swallow-project/swallow-ethernet-sdram-board/Manufacturing/BOM/Swallow-ethernet-BOM.xls

Swallow_Ethernet design V1
Bill of Materials
2012-10-10
Key:
Populated
Unpopulated
PCB Train free issue
ref | value | footprint
C1 | 10n | SM0402 | 040210nF 50V 10% X7R
C2 | 47n | SM0603 | 060347nF 16V 10% X7R
C3 | 100n | SM0603 | 0603100nF 25V 10% X7R
C4 | 100n | SM0603 | 0603100nF 25V 10% X7R
C5 | 10uF | SM0805 | 080510uF 6.3V 10% X5R
C6 | 100n | SM0603 | 0603100nF 25V 10% X7R
C7 | 100n | SM0603 | 0603101nF 25V 10% X7R
C8 | 100n | SM0603 | 0603102nF 25V 10% X7R
C9 | 100n | SM0603 | 0603103nF 25V 10% X7R
C10 | 100n | SM0603 | 0603104nF 25V 10% X7R
C11 | 10u | SM0805 | 080510uF 6.3V 10% X5R
C12 | 100n | SM0603 | 0603100nF 25V 10% X7R
C13 | 100n | SM0603 | 0603101nF 25V 10% X7R
C14 | 100n | SM0603 | 0603102nF 25V 10% X7R
C15 | 100n | SM0603 | 0603103nF 25V 10% X7R
C16 | 10u | SM0805 | 080510uF 6.3V 10% X5R
C17 | 10u | SM1206 | 120610uF 25V Z% Y5V
C18 | 10u | SM1206 | 120610uF 25V Z% Y5V
C19 | 33p | SM0603 | 060333pF 50V 5% C0G
C20 | 33p | SM0603 | 060333pF 50V 5% C0G
C21 | 10u | SM0805 | 080510uF 6.3V 10% X5R
C22 | 10u | SM0805 | 080510uF 6.3V 10% X5R |  |  |  | Price (assuming 10 boards)
C23 | 100n | SM0603 | 0603100nF 25V 10% X7R
D1 | MEM_LED | X_LED-0603 | Kingbright | KPT-1608EC | 2099221 | http://uk.farnell.com/kingbright/kpt-1608ec/led-red-0603-smd/dp/2099221?in_merch=New%20Products | 0.05
D2 | L1_LED | X_LED-0603 | Kingbright | KPT-1608EC | 2099221 | http://uk.farnell.com/kingbright/kpt-1608ec/led-red-0603-smd/dp/2099221?in_merch=New%20Products | 0.05
D3 | POWER_OK | X_LED-0603 | Dialight | 5988070107F | 1465991RL | http://uk.farnell.com/dialight/5988070107f/led-0603-green/dp/1465991RL | 0.26
D4 | RESET | X_LED-0603 | Dialight | 5988070107F | 1465991RL | http://uk.farnell.com/dialight/5988070107f/led-0603-green/dp/1465991RL | 0.26
L1 | 2.2uH | SM0805 | Taiyo Yuden | CBC2012T2R2M | 9544348 | http://uk.farnell.com/taiyo-yuden/cbc2012t2r2m/power-inductor-2-2uh-530ma-20/dp/9544348 | 0.1 | US
L2 | 2.2uH | SM0805 | Taiyo Yuden | CBC2012T2R2M | 9544348 | http://uk.farnell.com/taiyo-yuden/cbc2012t2r2m/power-inductor-2-2uh-530ma-20/dp/9544348 | 0.1 | US
P1 | XTAG2 | pin_array_10x2 | Harwin | M20-9990245 | 1022245 | http://uk.farnell.com/harwin/m20-9990245/header-1row-2way/dp/1022245 | 0.098
P2 | XMP16_TR_Link | FFC5-xx-R-L-Tx | Toby | FFC5-30-R-L-TU |  | http://www.toby.co.uk/content/catalogue/products.aspx?series=FFC5-xx-R-L-Tx | 0.62
P3 | TR_Link_Out | FFC5-xx-R-L-Tx | Toby | FFC5-30-R-L-TU |  | http://www.toby.co.uk/content/catalogue/products.aspx?series=FFC5-xx-R-L-Tx | 0.62
P4 | Mode_Select | SIL-2 | Harwin | M20-9990245 | 1022245 | http://uk.farnell.com/harwin/m20-9990245/header-1row-2way/dp/1022245 | 0.098
P5 | Ethernet_Slice | PCIe 36 way throughole vertical | Samtec | PCIE-036-02-F-D-TH | 1753906 | http://uk.farnell.com/samtec/pcie-036-02-f-d-th/socket-pci-e-2x18/dp/1753906 | 1.27
P6 | V_In
P7 | +5V_In | DC-8S | Cliff | FC68145S | 224947 | http://uk.farnell.com/cliff-electronic-components/dc8/socket-pcb-dc-power-1-3mm-pk10/dp/224947 | 0.573 | (pack of 10)
P8 | PCIe_extra
P9 | RESET_N
P10 | CONN_14
P11 | CONN_8
P12 | CONN_3
P13 | CONN_2
P14 | CONN_2
P15 | CONN_2
P16 | CONN_2
P17 | CONN_2
R1 | 33R | SM0402 | 040233R 1%
R2 | 33R | SM0402 | 040233R 1%
R5 | 4R7 | SM0402 | 04024R7 1%
R6 | 100k | SM0402 | 0402100K 1%
R7 | 100k | SM0402 | 0402100K 1%
R8 | 453k | SM0603 | Vishay | CRCW0603453KFKEA | 2138564 | http://uk.farnell.com/vishay-draloric/crcw0603453kfkea/resistor-0603-453k-1/dp/2138564?in_merch=New%20Products | 0.025 | (min 50 order factored in)
R9 | 68k | SM0402 | 040268K 1%
U1 | 25MHz_ASE_CLK | TC Series | TCX | TC-25.000MBD-T | 2100537 | http://uk.farnell.com/txc/tc-25-000mbd-t/oscillator-mems-cmos-25mhz-smd/dp/2100537 | 1.15 | US
U2 | 4k7 | YC124-JR | Yageo | YC124-JR-074K7L | 9235400RL | http://uk.farnell.com/yageo-phycomp/yc124-jr-074k7l/resistor-array-arv341-0804-4k7/dp/9235400RL | 0.112
U3 | 33R | YC124-JR | Yageo | YC124-JR-0733RL | 9235272RL | http://uk.farnell.com/yageo-phycomp/yc124-jr-0733rl/resistor-array-arv341-0804-33r/dp/9235272RL | 0.116
U4 | 33R | YC124-JR | Yageo | YC124-JR-0733RL | 9235272RL | http://uk.farnell.com/yageo-phycomp/yc124-jr-0733rl/resistor-array-arv341-0804-33r/dp/9235272RL | 0.116
U5 | NC7WZ07 | SC70-6 | Fairchild | NC7WZ07P6X | 1470998 | http://uk.farnell.com/fairchild-semiconductor/nc7wz07p6x/ic-nc7wz-smd/dp/1470998 | 0.24
U6 | NC7WZ07 | SC70-6 | Fairchild | NC7WZ07P6X | 1470998 | http://uk.farnell.com/fairchild-semiconductor/nc7wz07p6x/ic-nc7wz-smd/dp/1470998 | 0.24
U7 | 4k7 | YC124-JR | Yageo | YC124-JR-074K7L | 9235400RL | http://uk.farnell.com/yageo-phycomp/yc124-jr-074k7l/resistor-array-arv341-0804-4k7/dp/9235400RL | 0.112
U8 | MX25L6445EM2I-10G | SO8NL | Macronix | MX25L6445EM2I-10G | 1092-1065-ND | http://www.digikey.com/product-search/en?x=0&y=0&lang=en&site=us&KeyWords=MX25L6445EM2I-10G+ | 1.92
U9 | DRAM-2MX16X4 | TSSOP-54 | Hynix | H57V2562GTR-75C | 1907383 | http://uk.farnell.com/hynix-semiconductor/h57v2562gtr-75c/sdram-256mb-x16-54tsopii/dp/1907383 | 2.26
U10 | XS1-L1-128 | XMOS_X1-L1_128TQFP | XMOS | XS1-L01A-TQ128-C5 | 880-1019-ND | http://www.digikey.com/product-detail/en/XS1-L01A-TQ128-C5/880-1019-ND/2333460 | 10
U11 | NCP1529 | TSOP-5 | ON Semi | NCP1529ASNT1G | 1642398 | http://uk.farnell.com/on-semiconductor/ncp1529asnt1g/ic-step-down-dc-dc-converter-tsop/dp/1642398 | 0.518
U12 | NCP1529 | TSOP-5 | ON Semi | NCP1529ASNT1G | 1642398 | http://uk.farnell.com/on-semiconductor/ncp1529asnt1g/ic-step-down-dc-dc-converter-tsop/dp/1642398 | 0.518
U13 | NCP303LSN09T1G | TSOP-5 | ON Semi | NCP303LSN09T1G | 1364634 | http://uk.farnell.com/on-semiconductor/ncp303lsn09t1g/ic-volt-detector-0-45%C2%B5a-10v-tsop/dp/1364634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 | 0.236
U14 | 82R |  | Yageo | YC124-JR-074K7L | 9235400 | http://uk.farnell.com/yageo-phycomp/yc124-jr-074k7l/resistor-array-arv341-0804-4k7/dp/9235400 | 0.112
U15 | TS3A5018 |  | TI | TS3A5018PWG4 | 1494943 | http://uk.farnell.com/texas-instruments/ts3a5018pwg4/switch-analog-spdt-quad-10r-smd/dp/1494943 | 0.72
U16 | NC7WZ17 | SC70-6 | Fairchild | NC7WZ17P6X | 1651986RL | http://uk.farnell.com/fairchild-semiconductor/nc7wz17p6x/ic-buffers-drivers-receivers/dp/1651986RL | 0.2
W1 | CLK_EN | TestPad-1mm
W2 | CLK | TestPad-1mm
W3 | GPIO1 | TestPad-1mm
W4 | GPIO2 | TestPad-1mm
W5 | MODE3 | TestPad-1mm
W7 | 3V3Reg | TestPad-1mm
W8 | 1VReg | TestPad-1mm
W9 | 1VFB | TestPad-1mm
W10 | 3V3FB | TestPad-1mm
W11 | 3V3 | TestPad-1mm
W12 | 1V | TestPad-1mm
W13 | RESET_N | TestPad-1mm
 | 30 unique lines
 | 58 total parts
