swallow-project/swallow-ethernet-sdram-board/Swallow-ethernet.sch

## KiCad design Swallow-ethernet.sch (2012-12-03, an earlier design)

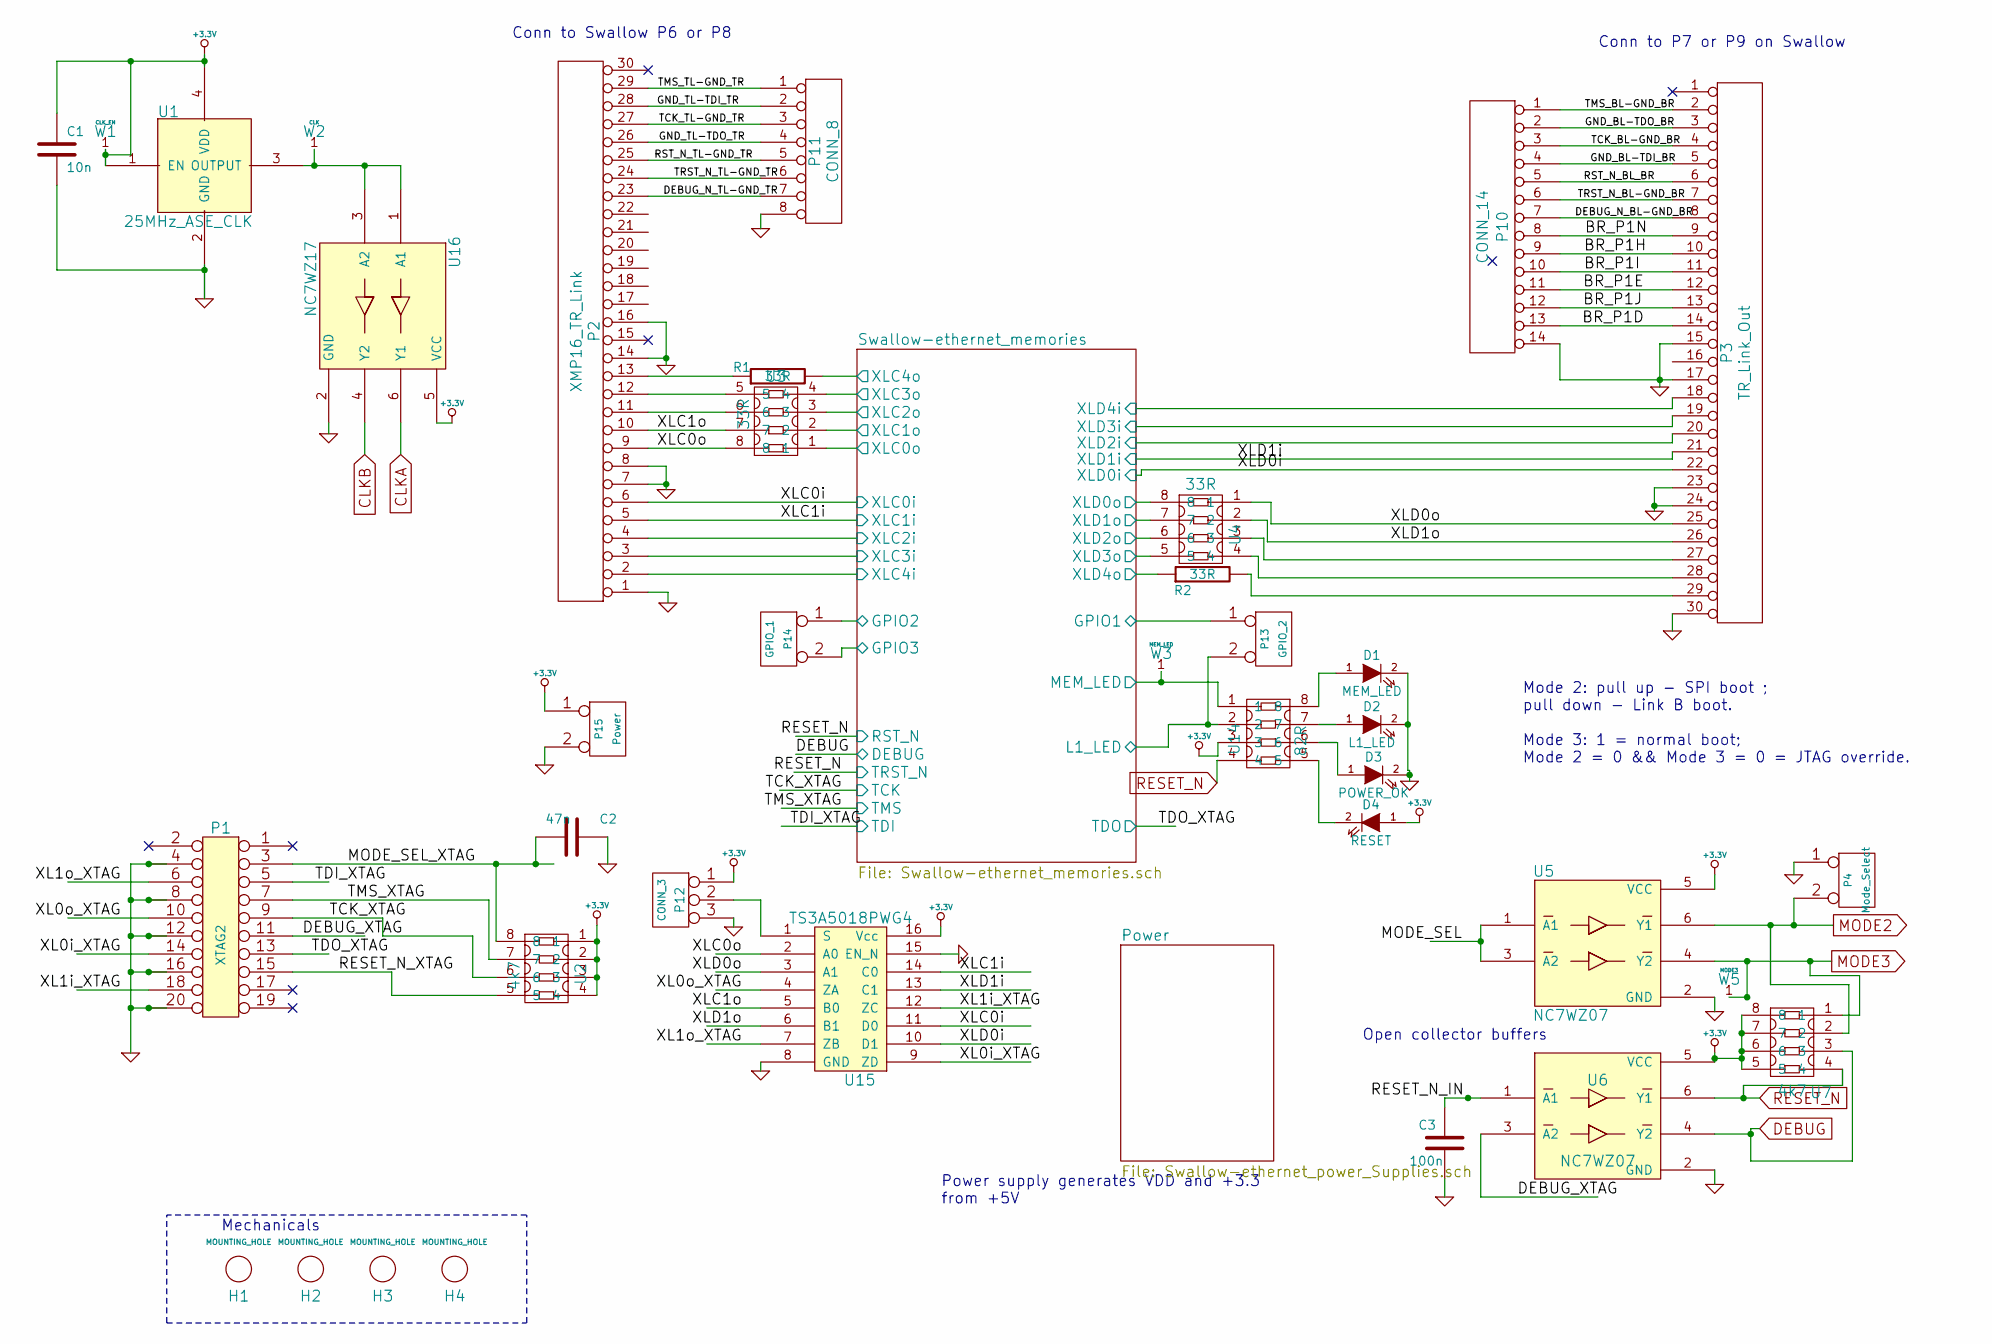
[picture p6: schematic Swallow-ethernet.sch]

Parts:
C1: 10n; SM0402
C2: 47n; SM0603
C3: 100n; SM0603
D1: MEM_LED; X_LED-0603
D2: L1_LED; X_LED-0603
D3: POWER_OK; X_LED-0603
D4: RESET; X_LED-0603
H1, H2, H3, H4: MOUNTING_HOLE
P1: XTAG2; pin_array_10x2
P2: XMP16_TR_Link; FFC5-xx-R-L-Tx
P3: TR_Link_Out; FFC5-xx-R-L-Tx
P4: Mode_Select; SIL-2
P10: CONN_14
P11: CONN_8
P12: CONN_3
P13: GPIO_2
P14: GPIO_1
P15: Power
R1, R2: 33R; SM0402
U1: 25MHz_ASE_CLK; ASEseries
U2, U7: 4k7; YC124-JR
U3, U4: 33R; YC124-JR
U5, U6: NC7WZ07; SC70-6
U14: 82R
U15: TS3A5018PWG4
U16: NC7WZ17
W1: CLK_EN; TestPad-1mm
W2: CLK; TestPad-1mm
W3: MEM_LED; TestPad-1mm
W5: MODE3; TestPad-1mm

Connections:
+3.3V: C1.1, D4.1 (A), P12.1, P15.1, U1.1 (EN), U1.4 (VDD), U2.1, U2.2, U2.3, U2.4, U5.5 (VCC), U6.5 (VCC), U7.5, U7.6, U7.7, U7.8, U14.3, U15.16 (Vcc), U16.5 (VCC), W1.1
BR_P1D: P3.14, P10.13
BR_P1E: P3.12, P10.11
BR_P1H: P3.10, P10.9
BR_P1I: P3.11, P10.10
BR_P1J: P3.13, P10.12
BR_P1N: P3.9, P10.8
CLKA: U16.6 (Y1)
CLKB: U16.4 (Y2)
DEBUG: U6.4 (Y2), U7.3
DEBUG_N_BL-GND_BR: P3.8, P10.7
DEBUG_N_TL-GND_TR: P2.23, P11.7
DEBUG_XTAG: P1.11, U6.3 (A2)
GND: C1.2, C2.1, C3.2, D1.2 (K), D2.2 (K), D3.2 (K), P1.4, P1.8, P1.12, P1.16, P1.20, P2.1, P2.7, P2.8, P2.14, P2.16, P3.15, P3.17, P3.23, P3.24, P3.30, P4.1, P10.14, P11.8, P12.3, P15.2 (PM), U1.2 (GND), U5.2 (GND), U6.2 (GND), U15.8 (GND), U15.15 (EN_N), U16.2 (GND)
GND_BL-TDI_BR: P3.5, P10.4
GND_BL-TDO_BR: P3.3, P10.2
GND_TL-TDI_TR: P2.28, P11.2
GND_TL-TDO_TR: P2.26, P11.4
GPIO1: P13.1
GPIO2: P14.1
GPIO3: P14.2 (PM)
L1_LED: P13.2 (PM), U14.2
MEM_LED: U14.1, W3.1
MODE2: P4.2 (PM), U5.6 (Y1), U7.2
MODE3: U5.4 (Y2), U7.1, W5.1
MODE_SEL: U5.1 (A1), U5.3 (A2)
MODE_SEL_XTAG: C2.2, P1.3, U2.8
unnamed: D1.1 (A), U14.8
unnamed: D2.1 (A), U14.7
unnamed: D3.1 (A), U14.6
unnamed: D4.2 (K), U14.5
unnamed: P2.11, U3.6
unnamed: P2.12, U3.5
unnamed: P2.13, R1.1
unnamed: P3.27, U4.3
unnamed: P3.28, U4.4
unnamed: P3.29, R2.2
unnamed: P12.2 (PM), U15.1 (S)
unnamed: U1.3 (OUTPUT), U16.1 (A1), U16.3 (A2), W2.1
RESET_N: U6.6 (Y1), U7.4, U14.4
RESET_N_IN: C3.1, U6.1 (A1)
RESET_N_XTAG: P1.15, U2.5
RST_N_BL_BR: P3.6, P10.5
RST_N_TL-GND_TR: P2.25, P11.5
TCK_BL-GND_BR: P3.4, P10.3
TCK_TL-GND_TR: P2.27, P11.3
TCK_XTAG: P1.9, U2.6
TDI_XTAG: P1.5
TDO_XTAG: P1.13
TMS_BL-GND_BR: P3.2, P10.1
TMS_TL-GND_TR: P2.29, P11.1
TMS_XTAG: P1.7, U2.7
TRST_N_BL-GND_BR: P3.7, P10.6
TRST_N_TL-GND_TR: P2.24, P11.6
XL0i_XTAG: P1.14, U15.9 (ZD)
XL0o_XTAG: P1.10, U15.4 (ZA)
XL1i_XTAG: P1.18, U15.12 (ZC)
XL1o_XTAG: P1.6, U15.7 (ZB)
XLC0i: P2.6, U15.11 (D0)
XLC0o: P2.9, U3.1, U3.8, U15.2 (A0)
XLC1i: P2.5, U15.14 (C0)
XLC1o: P2.10, U3.2, U3.7, U15.5 (B0)
XLC2i: P2.4
XLC2o: U3.3
XLC3i: P2.3
XLC3o: U3.4
XLC4i: P2.2
XLC4o: R1.2
XLD0i: P3.22, U15.10 (D1)
XLD0o: P3.25, U4.1, U4.8, U15.3 (A1)
XLD1i: P3.21, U15.13 (C1)
XLD1o: P3.26, U4.2, U4.7, U15.6 (B1)
XLD2i: P3.20
XLD2o: U4.6
XLD3i: P3.19
XLD3o: U4.5
XLD4i: P3.18
XLD4o: R2.1

Notes on the sheet:
Mechanicals
Conn to Swallow P6 or P8
Conn to P7 or P9 on Swallow
Mode 2: pull up - SPI boot ; pull down - Link B boot. Mode 3: 1 = normal boot; Mode 2 = 0 && Mode 3 = 0 = JTAG override.
Open collector buffers
Power supply generates VDD and +3.3 from +5V
