swallow-project/swallow-ethernet-sdram-board/Swallow-ethernet_XS1-L1-128-ports.sch

## KiCad design Swallow-ethernet_XS1-L1-128-ports.sch (2012-12-03, an earlier design)

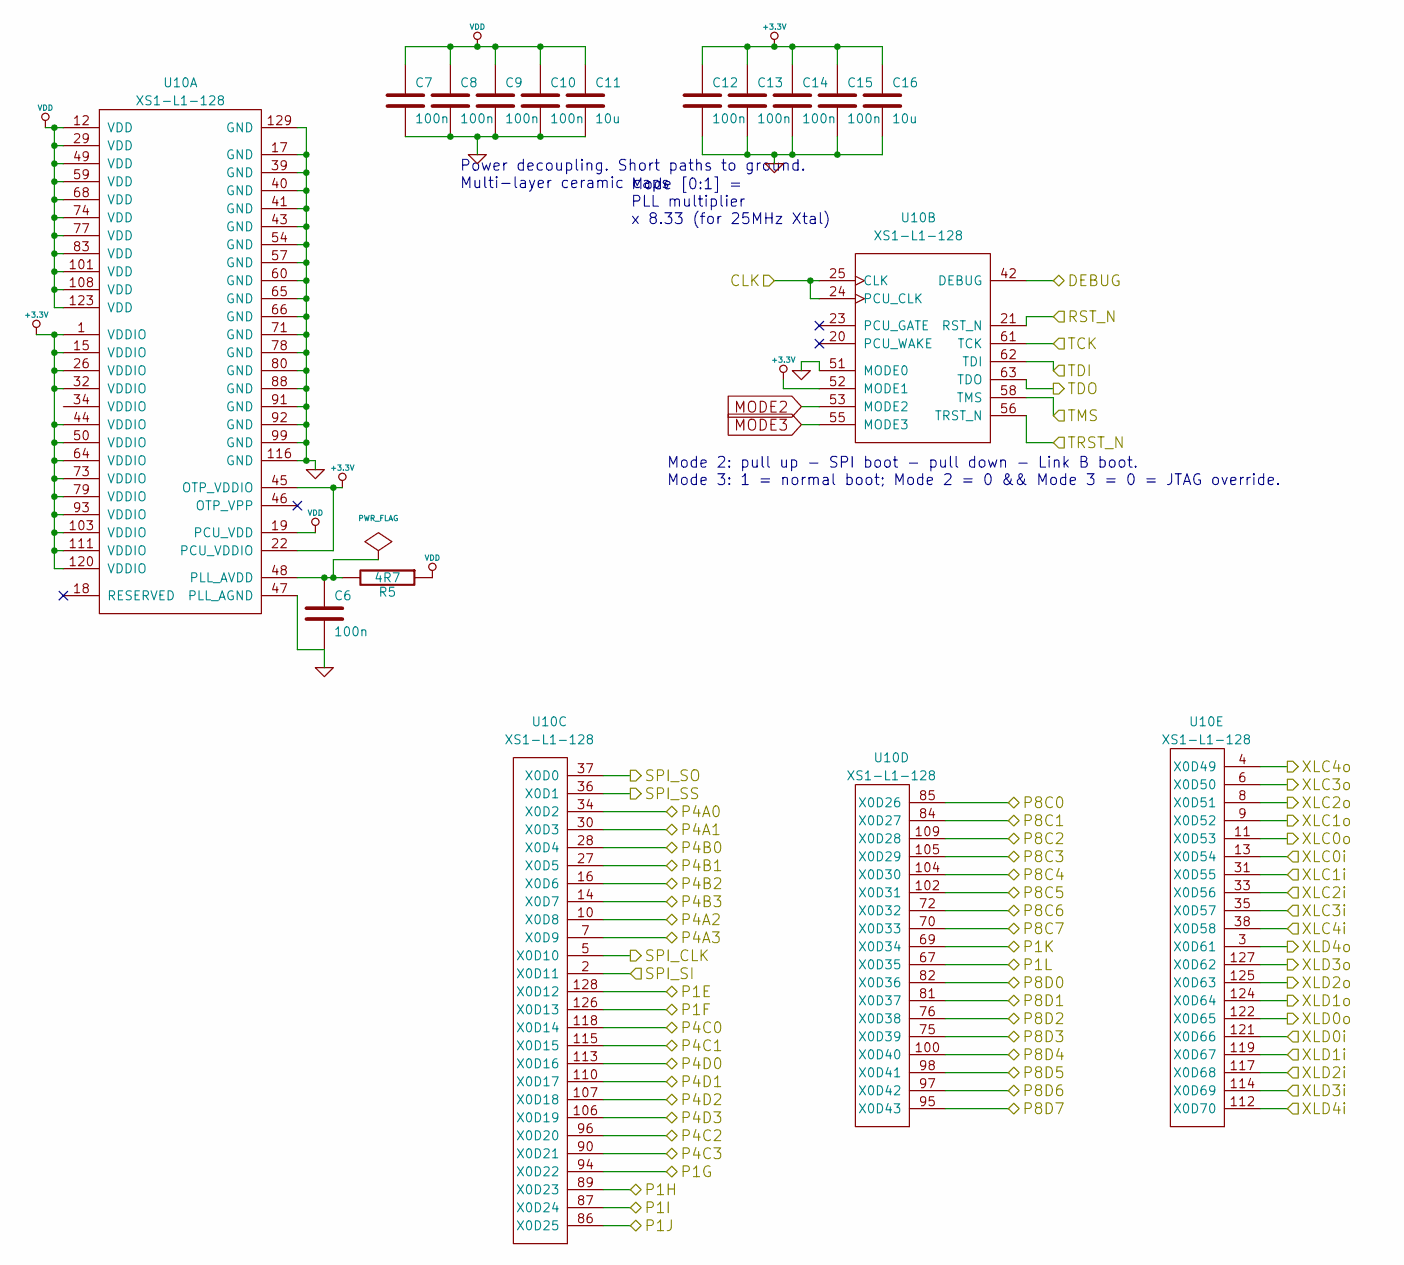
[picture p7: schematic Swallow-ethernet_XS1-L1-128-ports.sch]

Parts:
C6, C7, C8, C9, C10, C12, C13, C14, C15: 100n; SM0603
C11, C16: 10u; SM0805
R5: 4R7; SM0402
U10: XS1-L1-128; XMOS_X1-L1_128TQFP

Connections:
+3.3V: C12.1, C13.1, C14.1, C15.1, C16.1, U10.1 (VDDIO), U10.15 (VDDIO), U10.22 (PCU_VDDIO), U10.26 (VDDIO), U10.32 (VDDIO), U10.44 (VDDIO), U10.45 (OTP_VDDIO), U10.50 (VDDIO), U10.52 (MODE1), U10.64 (VDDIO), U10.73 (VDDIO), U10.79 (VDDIO), U10.93 (VDDIO), U10.103 (VDDIO), U10.111 (VDDIO), U10.120 (VDDIO)
CLK: U10.24 (PCU_CLK), U10.25 (CLK)
DEBUG: U10.42 (DEBUG)
GND: C6.2, C7.2, C8.2, C9.2, C10.2, C11.2, C12.2, C13.2, C14.2, C15.2, C16.2, U10.17 (GND), U10.39 (GND), U10.40 (GND), U10.41 (GND), U10.43 (GND), U10.47 (PLL_AGND), U10.51 (MODE0), U10.54 (GND), U10.57 (GND), U10.60 (GND), U10.65 (GND), U10.66 (GND), U10.71 (GND), U10.78 (GND), U10.80 (GND), U10.88 (GND), U10.91 (GND), U10.92 (GND), U10.99 (GND), U10.116 (GND), U10.129 (GND)
MODE2: U10.53 (MODE2)
MODE3: U10.55 (MODE3)
unnamed: C6.1, R5.2, U10.48 (PLL_AVDD)
P1E: U10.128 (X0D12)
P1F: U10.126 (X0D13)
P1G: U10.94 (X0D22)
P1H: U10.89 (X0D23)
P1I: U10.87 (X0D24)
P1J: U10.86 (X0D25)
P1K: U10.69 (X0D34)
P1L: U10.67 (X0D35)
P4A0: U10.34 (VDDIO)
P4A1: U10.30 (X0D3)
P4A2: U10.10 (X0D8)
P4A3: U10.7 (X0D9)
P4B0: U10.28 (X0D4)
P4B1: U10.27 (X0D5)
P4B2: U10.16 (X0D6)
P4B3: U10.14 (X0D7)
P4C0: U10.118 (X0D14)
P4C1: U10.115 (X0D15)
P4C2: U10.96 (X0D20)
P4C3: U10.90 (X0D21)
P4D0: U10.113 (X0D16)
P4D1: U10.110 (X0D17)
P4D2: U10.107 (X0D18)
P4D3: U10.106 (X0D19)
P8C0: U10.85 (X0D26)
P8C1: U10.84 (X0D27)
P8C2: U10.109 (X0D28)
P8C3: U10.105 (X0D29)
P8C4: U10.104 (X0D30)
P8C5: U10.102 (X0D31)
P8C6: U10.72 (X0D32)
P8C7: U10.70 (X0D33)
P8D0: U10.82 (X0D36)
P8D1: U10.81 (X0D37)
P8D2: U10.76 (X0D38)
P8D3: U10.75 (X0D39)
P8D4: U10.100 (X0D40)
P8D5: U10.98 (X0D41)
P8D6: U10.97 (X0D42)
P8D7: U10.95 (X0D43)
RST_N: U10.21 (RST_N)
SPI_CLK: U10.5 (X0D10)
SPI_SI: U10.2 (X0D11)
SPI_SO: U10.37 (X0D0)
SPI_SS: U10.36 (X0D1)
TCK: U10.61 (TCK)
TDI: U10.62 (TDI)
TDO: U10.63 (TDO)
TMS: U10.58 (TMS)
TRST_N: U10.56 (TRST_N)
VDD: C7.1, C8.1, C9.1, C10.1, C11.1, R5.1, U10.12 (VDD), U10.19 (PCU_VDD), U10.29 (VDD), U10.49 (VDD), U10.59 (VDD), U10.68 (VDD), U10.74 (VDD), U10.77 (VDD), U10.83 (VDD), U10.101 (VDD), U10.108 (VDD), U10.123 (VDD)
XLC0i: U10.13 (X0D54)
XLC0o: U10.11 (X0D53)
XLC1i: U10.31 (X0D55)
XLC1o: U10.9 (X0D52)
XLC2i: U10.33 (X0D56)
XLC2o: U10.8 (X0D51)
XLC3i: U10.35 (X0D57)
XLC3o: U10.6 (X0D50)
XLC4i: U10.38 (X0D58)
XLC4o: U10.4 (X0D49)
XLD0i: U10.121 (X0D66)
XLD0o: U10.122 (X0D65)
XLD1i: U10.119 (X0D67)
XLD1o: U10.124 (X0D64)
XLD2i: U10.117 (X0D68)
XLD2o: U10.125 (X0D63)
XLD3i: U10.114 (X0D69)
XLD3o: U10.127 (X0D62)
XLD4i: U10.112 (X0D70)
XLD4o: U10.3 (X0D61)

Notes on the sheet:
Mode 2: pull up - SPI boot - pull down - Link B boot. Mode 3: 1 = normal boot; Mode 2 = 0 && Mode 3 = 0 = JTAG override.
Mode [0:1] = PLL multiplier x 8.33 (for 25MHz Xtal)
Power decoupling. Short paths to ground. Multi-layer ceramic caps
