swallow-project/swallow-ethernet-sdram-board/Swallow-ethernet_memories.sch

## KiCad design Swallow-ethernet_memories.sch (2012-12-03, an earlier design)

Schematic: Swallow-ethernet_memories.sch

Parts:
C4: 100n; SM0603
C5: 10uF; SM0805
P5: Ethernet_Slice
P8: PCIe_extra
P9: RESET_N
P16: P4B{2,3}
U8: MX25L6445EM2I-10G; SO8NL
U9: DRAM-2MX16X4; TSSOP-54

Notes on the sheet:
B17 is unused INT_N B18 in unused RXER
LDQM + UDQM = Output enable_N Can be used individually to set the device into 8bit mode. 8 bit version of the device available.
