swallow-project/swallow-ethernet-sdram-board/Swallow-ethernet_power_Supplies.sch

## KiCad design Swallow-ethernet_power_Supplies.sch (2012-12-03, an earlier design)

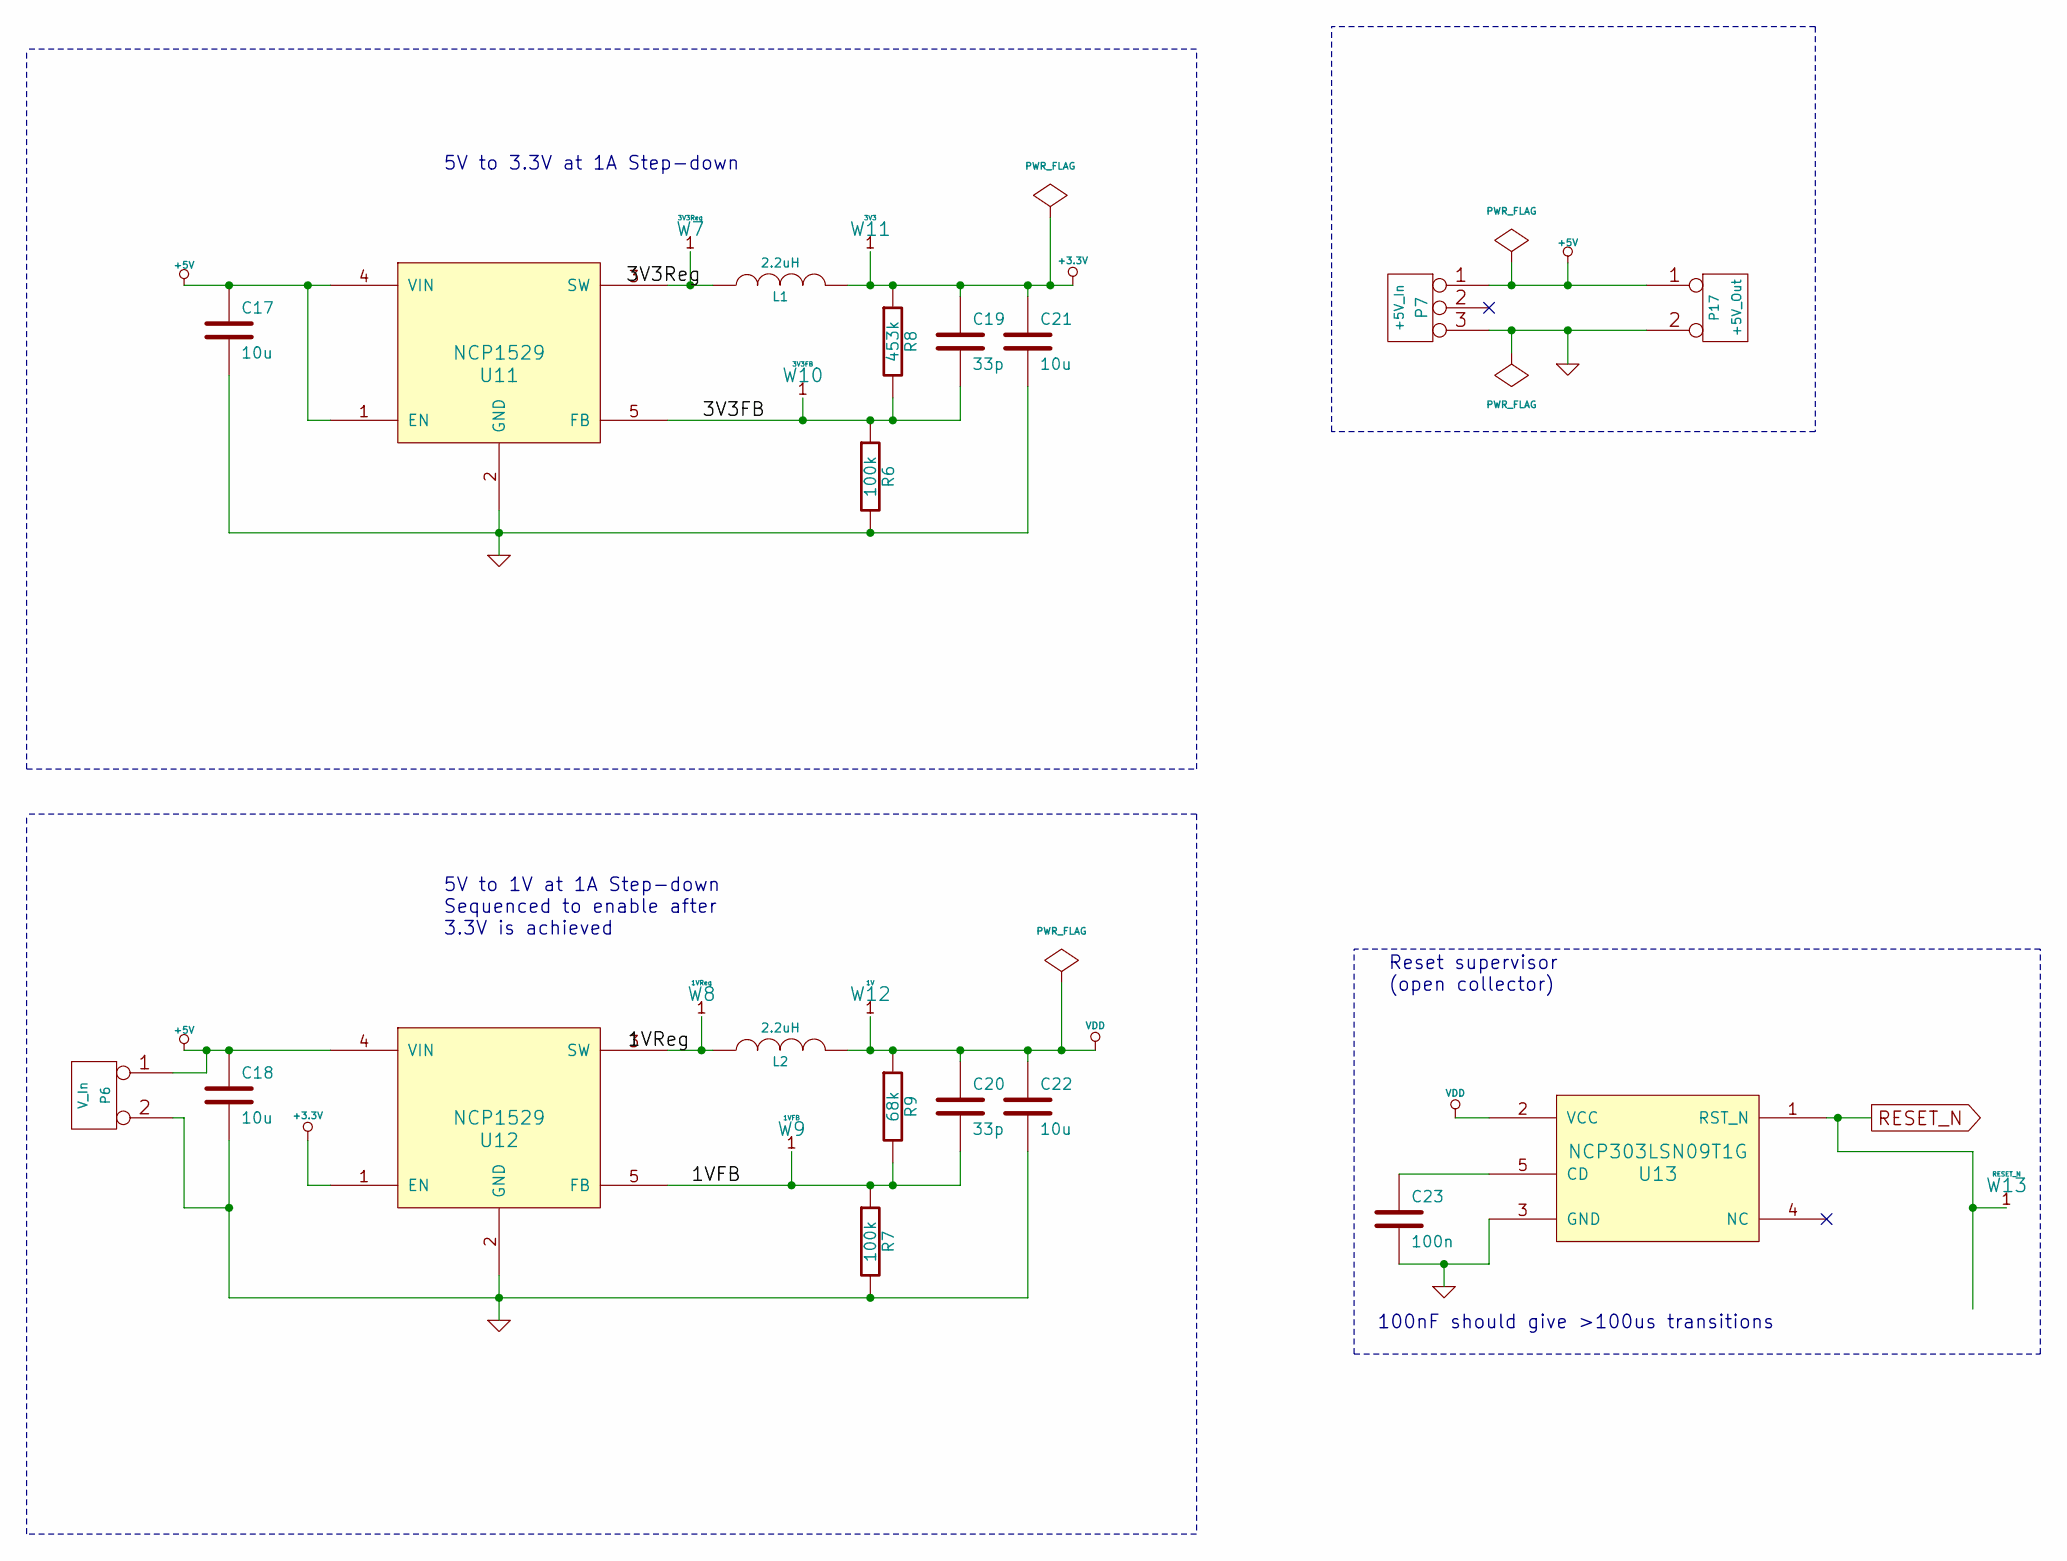
[picture p8: schematic Swallow-ethernet_power_Supplies.sch]

Parts:
C17, C18, C21, C22: 10u; SM0805
C19, C20: 33p; SM0603
C23: 100n; SM0402
L1, L2: 2.2uH; SM0805
P6: V_In
P7: +5V_In; DC-8S
P17: +5V_Out
R6, R7: 100k; SM0402
R8: 453k; SM0805
R9: 68k; SM0402
U11, U12: NCP1529; TSOP-5
U13: NCP303LSN09T1G; TSOP-5
W7: 3V3Reg; TestPad-1mm
W8: 1VReg; TestPad-1mm
W9: 1VFB; TestPad-1mm
W10: 3V3FB; TestPad-1mm
W11: 3V3; TestPad-1mm
W12: 1V; TestPad-1mm
W13: RESET_N; TestPad-1mm

Connections:
1VFB: C20.2, R7.1, R9.2, U12.5 (FB), W9.1
1VReg: L2.1, U12.3 (SW), W8.1
3V3FB: C19.2, R6.1, R8.2, U11.5 (FB), W10.1
3V3Reg: L1.1, U11.3 (SW), W7.1
+3.3V: C19.1, C21.1, L1.2, R8.1, U12.1 (EN), W11.1
+5V: C17.1, C18.1, P6.1, P7.1, P17.1, U11.1 (EN), U11.4 (VIN), U12.4 (VIN)
GND: C17.2, C18.2, C21.2, C22.2, C23.2, P6.2 (PM), P7.3, P17.2 (PM), R6.2, R7.2, U11.2 (GND), U12.2 (GND), U13.3 (GND)
unnamed: C23.1, U13.5 (CD)
RESET_N: U13.1 (RST_N), W13.1
VDD: C20.1, C22.1, L2.2, R9.1, U13.2 (VCC), W12.1

Notes on the sheet:
100nF should give >100us transitions
Reset supervisor (open collector)
5V to 1V at 1A Step-down Sequenced to enable after 3.3V is achieved
5V to 3.3V at 1A Step-down
