swallow-project/swallow-ethernet-sdram-board/(commit log)

2012-09-29 Created new repository for Swallow ethernet addon, based on XK-16 project design.
    [Swallow-ethernet.brd, Swallow-ethernet.sch, Swallow-ethernet_XS1-L1-128-ports.sch, Swallow-ethernet_memories.sch, Swallow-ethernet_power_Supplies.sch, XS1-L1-128-ports.sch]
2012-09-30 Created pinout for SDRAM + ethernet I/O board. Pushed pinout to schematic.
    [Swallow-ethernet.sch, Swallow-ethernet_XS1-L1-128-ports.sch, Swallow-ethernet_memories.sch, Swallow-ethernet_power_Supplies.sch]
2012-09-30 Completed schematic.
    [Swallow-ethernet.sch, Swallow-ethernet_XS1-L1-128-ports.sch, Swallow-ethernet_memories.sch, Swallow-ethernet_power_Supplies.sch]
2012-09-30 Re-annotated schematic and deleted redundant components from PCB design.
    [Swallow-ethernet.brd, Swallow-ethernet.sch, Swallow-ethernet_XS1-L1-128-ports.sch, Swallow-ethernet_memories.sch, Swallow-ethernet_power_Supplies.sch]
2012-09-30 Re-routed DRAM signals, but realise that the Link signals have been accidentally deleted. Need to revert..
    [Swallow-ethernet.brd, Swallow-ethernet.sch, Swallow-ethernet_XS1-L1-128-ports.sch, Swallow-ethernet_memories.sch, Swallow-ethernet_power_Supplies.sch]
2012-09-30 Imported new footprints to PCB. Still a discrepancy in naming schematic to PCB, but connectivity seems to be OK. Needs checking though! Created PCIe header footprint for SMD. Routing is going to be v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
    [Swallow-ethernet.brd, Swallow-ethernet.sch, Swallow-ethernet_XS1-L1-128-ports.sch, Swallow-ethernet_memories.sch, Swallow-ethernet_power_Supplies.sch]
2012-10-01 Provisional placement of new headers in PCB.
    [Swallow-ethernet.brd]
2012-10-01 Completed IO signal pinouts of the PCIe header.
    [Swallow-ethernet.brd, Swallow-ethernet.sch, Swallow-ethernet_XS1-L1-128-ports.sch, Swallow-ethernet_memories.sch, Swallow-ethernet_power_Supplies.sch]
2012-10-01 Routing Link XLC
    [Swallow-ethernet.brd]
2012-10-01 All XLC I/O lines routed.
    [Swallow-ethernet.brd, Swallow-ethernet.sch, Swallow-ethernet_XS1-L1-128-ports.sch, Swallow-ethernet_memories.sch, Swallow-ethernet_power_Supplies.sch]
2012-10-01 Minor track clean-up
    [Swallow-ethernet.brd]
2012-10-01 Back-annotated PCB layout footprints to component file. This solves netlist import warnings.
2012-10-01 Converted LED resistors from individuals to array. Connected most signals.
    [Swallow-ethernet.brd, Swallow-ethernet.sch, Swallow-ethernet_XS1-L1-128-ports.sch, Swallow-ethernet_memories.sch, Swallow-ethernet_power_Supplies.sch]
2012-10-01 Completed layout :)
    [Swallow-ethernet.brd]
2012-10-01 Finished silkscreen including Swallow logos.
2012-10-01 Generated gerbers and drills and added to repository.
    [Swallow-ethernet-Back.gbl, Swallow-ethernet-Comments.gbr, Swallow-ethernet-Front.gtl, Swallow-ethernet-Mask_Back.gbs, Swallow-ethernet-Mask_Front.gts, Swallow-ethernet-NPTH.drl, Swallow-ethernet-SilkS_Back.gbo, Swallow-ethernet-SoldP_Back.gbp]
2012-10-01 P6 reference moved.
    [Swallow-ethernet-Back.gbl, Swallow-ethernet-Comments.gbr, Swallow-ethernet-Front.gtl, Swallow-ethernet-Mask_Back.gbs, Swallow-ethernet-Mask_Front.gts, Swallow-ethernet-SilkS_Back.gbo, Swallow-ethernet-SoldP_Back.gbp, Swallow-ethernet-SoldP_Front.gtp]
2012-10-02 Altered +5V capacitors to larger size for higher V rating. Changed reset chip cap from 100pF to 100nF to ensure a longer reset signal for the ethernet MAC.
    [Swallow-ethernet-Back.gbl, Swallow-ethernet-Comments.gbr, Swallow-ethernet-Front.gtl, Swallow-ethernet-Mask_Back.gbs, Swallow-ethernet-Mask_Front.gts, Swallow-ethernet-SilkS_Back.gbo, Swallow-ethernet-SoldP_Back.gbp, Swallow-ethernet-SoldP_Front.gtp]
2012-10-02 Minor pad adjustment.
    [Swallow-ethernet-Back.gbl, Swallow-ethernet-Comments.gbr, Swallow-ethernet-Front.gtl, Swallow-ethernet-Mask_Back.gbs, Swallow-ethernet-Mask_Front.gts, Swallow-ethernet-NPTH.drl, Swallow-ethernet-SilkS_Back.gbo, Swallow-ethernet-SoldP_Back.gbp]
2012-10-03 Configured links to be compatible with N1, N2, S1, S2 of Swallow V2 board. Added break-out header for S1 and S2 links. Improved ground loops.
    [Swallow-ethernet.brd, Swallow-ethernet.sch, Swallow-ethernet_XS1-L1-128-ports.sch, Swallow-ethernet_memories.sch, Swallow-ethernet_power_Supplies.sch]
2012-10-04 Added XTAG link MUX and second breakout header to schematic.
    [Swallow-ethernet.brd, Swallow-ethernet.sch, Swallow-ethernet_XS1-L1-128-ports.sch, Swallow-ethernet_memories.sch, Swallow-ethernet_power_Supplies.sch]
2012-10-04 Working on making XTAG connection selectable via a MUX from either header. Tricky to route without long wiring. May reconsider or re-place.
    [Swallow-ethernet.brd, Swallow-ethernet.sch, Swallow-ethernet_XS1-L1-128-ports.sch, Swallow-ethernet_memories.sch, Swallow-ethernet_power_Supplies.sch]
2012-10-04 Finished layout with MUXed XTAG link.
    [Swallow-ethernet.brd]
2012-10-04 Updated silkscreen so that it all fits and looks nice with recent changes.
    [Swallow-ethernet-Back.gbl, Swallow-ethernet-Comments.gbr, Swallow-ethernet-Front.gtl, Swallow-ethernet-Mask_Back.gbs, Swallow-ethernet-Mask_Front.gts, Swallow-ethernet-NPTH.drl, Swallow-ethernet-SilkS_Back.gbo, Swallow-ethernet-SoldP_Back.gbp]
2012-10-06 Completed labelling of breakout ports.
    [Swallow-ethernet.brd, Swallow-ethernet.sch, Swallow-ethernet_XS1-L1-128-ports.sch, Swallow-ethernet_memories.sch, Swallow-ethernet_power_Supplies.sch]
2012-10-06 Moved the XTAG link select pins and updated silkscreeen.
    [Swallow-ethernet.brd, Swallow-ethernet.sch, Swallow-ethernet_XS1-L1-128-ports.sch, Swallow-ethernet_memories.sch, Swallow-ethernet_power_Supplies.sch]
2012-10-06 Created throughole PCIe connector footprint, based on Samtec PCIE-036-02-F-D-TH part.
    [Swallow-ethernet.brd]
2012-10-06 Updated layout to use through-hole PCIe connector. This gives more flexibility.
    [Swallow-ethernet-Back.gbl, Swallow-ethernet-Comments.gbr, Swallow-ethernet-Front.gtl, Swallow-ethernet-Mask_Back.gbs, Swallow-ethernet-Mask_Front.gts, Swallow-ethernet-NPTH.drl, Swallow-ethernet-SilkS_Back.gbo, Swallow-ethernet-SoldP_Back.gbp]
2012-10-06 Minor adjustment to remove a via from open solder mask under PCIe connector.
    [Swallow-ethernet-Back.gbl, Swallow-ethernet-Comments.gbr, Swallow-ethernet-Front.gtl, Swallow-ethernet-Mask_Back.gbs, Swallow-ethernet-Mask_Front.gts, Swallow-ethernet-NPTH.drl, Swallow-ethernet-SilkS_Back.gbo, Swallow-ethernet-SoldP_Back.gbp]
2012-10-06 Updated PCIe footprints to shrink holes and match suggested footprint exactly.
    [Swallow-ethernet-Back.gbl, Swallow-ethernet-Comments.gbr, Swallow-ethernet-Front.gtl, Swallow-ethernet-Mask_Back.gbs, Swallow-ethernet-Mask_Front.gts, Swallow-ethernet-NPTH.drl, Swallow-ethernet-SilkS_Back.gbo, Swallow-ethernet-SoldP_Back.gbp]
2012-10-06 Further, tiny adjust of the track under the PCIe connector.
    [Swallow-ethernet-Back.gbl, Swallow-ethernet-Comments.gbr, Swallow-ethernet-Front.gtl, Swallow-ethernet-Mask_Back.gbs, Swallow-ethernet-Mask_Front.gts, Swallow-ethernet-NPTH.drl, Swallow-ethernet-SilkS_Back.gbo, Swallow-ethernet-SoldP_Back.gbp]
2012-10-06 Created draft BOM for the boards.
    [Swallow-ethernet-BOM.ods]
2012-10-08 Added proper GPIO header and connected a second GPIO to the flash part.
    [Swallow-ethernet-Back.gbl, Swallow-ethernet-Comments.gbr, Swallow-ethernet-Front.gtl, Swallow-ethernet-Mask_Back.gbs, Swallow-ethernet-Mask_Front.gts, Swallow-ethernet-NPTH.drl, Swallow-ethernet-SilkS_Back.gbo, Swallow-ethernet-SoldP_Back.gbp]
2012-10-09 Added extra GPIO header from flash pins. Changed LED connection to CLK.
    [Swallow-ethernet.sch, Swallow-ethernet_XS1-L1-128-ports.sch, Swallow-ethernet_memories.sch, Swallow-ethernet_power_Supplies.sch]
2012-10-09 Placed the new GPIO headers. Alpha production candidate.
    [Swallow-ethernet-Back.gbl, Swallow-ethernet-Comments.gbr, Swallow-ethernet-Front.gtl, Swallow-ethernet-Mask_Back.gbs, Swallow-ethernet-Mask_Front.gts, Swallow-ethernet-NPTH.drl, Swallow-ethernet-SilkS_Back.gbo, Swallow-ethernet-SoldP_Back.gbp]
2012-10-09 Added B16 & B18 annotation.
    [Swallow-ethernet-Back.gbl, Swallow-ethernet-Comments.gbr, Swallow-ethernet-Front.gtl, Swallow-ethernet-Mask_Back.gbs, Swallow-ethernet-Mask_Front.gts, Swallow-ethernet-SilkS_Back.gbo, Swallow-ethernet-SoldP_Back.gbp, Swallow-ethernet-SoldP_Front.gtp]
2012-10-10 Placed four 3mm mounting holes.
    [Swallow-ethernet-BOM.ods, Swallow-ethernet.brd, Swallow-ethernet.sch, Swallow-ethernet_XS1-L1-128-ports.sch, Swallow-ethernet_memories.sch, Swallow-ethernet_power_Supplies.sch]
2012-10-10 Resized solder mask and generated manufacturing data.
    [Swallow-ethernet-Back.gbl, Swallow-ethernet-Comments.gbr, Swallow-ethernet-Front.gtl, Swallow-ethernet-Mask_Back.gbs, Swallow-ethernet-Mask_Front.gts, Swallow-ethernet-NPTH.drl, Swallow-ethernet-SilkS_Back.gbo, Swallow-ethernet-SoldP_Back.gbp]
2012-10-10 Added completed BOM.
    [Swallow-ethernet-BOM.ods]
2012-10-11 Swapped BA0 & BA1 from 4 bit port to bits 13&14 of the address 16 bit port, following Andrew Stanford-Jason's suggestions. Re-laid out. GND plane also improved.
    [Swallow-ethernet.brd, Swallow-ethernet.sch, Swallow-ethernet_XS1-L1-128-ports.sch, Swallow-ethernet_memories.sch, Swallow-ethernet_power_Supplies.sch]
2012-10-11 Added pinouts for power and now free P4B2&P4B3 pins
    [Swallow-ethernet.brd]
2012-10-11 Added clock buffer for L1 + ethernet MAC. Updated BOM.
    [Swallow-ethernet-BOM.ods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]
2012-10-15 Added BIG logo to silkscreen.
    [Swallow-ethernet-BOM.ods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]
2012-10-15 Migrating L1 land pattern to proper centre pads.
    [Swallow-ethernet-Back.gbl, Swallow-ethernet-Comments.gbr, Swallow-ethernet-Front.gtl, Swallow-ethernet-Mask_Back.gbs, Swallow-ethernet-Mask_Front.gts, Swallow-ethernet-NPTH.drl, Swallow-ethernet-SilkS_Back.gbo, Swallow-ethernet-SoldP_Back.gbp]
2012-10-15 Completed new 3x3 grid array of solder paste and vias under the L1 GND slug.
    [Swallow-ethernet-Back.gbl, Swallow-ethernet-Comments.gbr, Swallow-ethernet-Front.gtl, Swallow-ethernet-Mask_Back.gbs, Swallow-ethernet-Mask_Front.gts, Swallow-ethernet-NPTH.drl, Swallow-ethernet-SilkS_Back.gbo, Swallow-ethernet-SoldP_Back.gbp]
2012-10-15 Generated manufacturing data.
    [Swallow-ethernet-BOM.xls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]
2012-10-15 Added a few more descriptions onto silkscreen.
    [Swallow-ethernet-BOM.ods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]
2012-10-16 Added another +5V header and cleaned up via inside PCIe header.
    [Swallow-ethernet-BOM.xls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]
2012-10-16 Re-added schematic.
2012-11-19 V2 begin. Bugs fixed and pushed to layout * RESET_N_IN => RESET_N_XTAG and associated wire connection * Fixed silkscreen P10 Pin 1 "GND" => "TMS" * Fixed unconnected ground link vias above P5
    [Swallow-ethernet.sch, Swallow-ethernet_XS1-L1-128-ports.sch, Swallow-ethernet_memories.sch, Swallow-ethernet_power_Supplies.sch]
2012-12-03 Found and fixed bug in design: MODE_SEL input to U5 was not connected to XTAG due to name mis-match. Effect is to always pull MODE[2:3] down, preventing Flash or LinkB boot. Now fixed in schematic an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
    [Swallow-ethernet.sch, Swallow-ethernet_XS1-L1-128-ports.sch, Swallow-ethernet_memories.sch, Swallow-ethernet_power_Supplies.sch]
2012-12-03 Added working SPI Flash spec file for 'xflash'.
2013-02-10 Added some missing footprint files.
